hotchk155/MIDI-Switcher-2/docs/Relay Switcher/Relay Switcher - Packing Slip.docx

RELAY SWITCHER

The information on this page is the bare minimum needed to build the project,

however you will find more information at http://six4pix.com/relays

I recommend you check the expanded instructions before you start building the board.

Here are the component designators used on the PCB:

R1, R11 R2-R9 R10, R12 R13 C1 C2,C3,C4 C5 D2 D3 PWR, ACT IC1 IC2 IC3 MODE 5VDC MIDI_IN | 1K RESISTOR (X2) 100R RESISTOR (x8) 1K5 RESISTOR (X2) 220R RESISTOR R10 is the unlabelled resistor above R11. R3-R9 are the unlabelled resistors between R2 and R10. 47UF 50V ELECTROLYTIC CAPACITOR 100nF CERAMIC CAPACITOR (X3) 4U7 10V ELECTROLYTIC CAPACITOR 1N4001 RECTIFIER DIODE 1N4148 SIGNAL DIODE 3MM LEDS (x2) PIC16F1825 MICROCONTROLLER (In Socket) 6N138 OPTOCOUPLER (In Socket) 3.3V 0.1A VOLTAGE REGULATOR TO92 6MM TACTILE SWITCH DOUBLE TERMINAL BLOCK 5MM 5 PIN DIN PCB MOUNT SOCKET Please carefully check the polarity of C1, C5, D2, D3, IC3 and all LEDs before soldering!

Solder the module to the pin header on the relay board.

Attach the 4 nylon stand-offs to the base plate using the screws.

Place the relay board on the stand-offs and use the nuts to secure the relay module to the base.

Use the brass stand-offs to support the relay switcher module above the upper part of the base plate.

The default MIDI note to port mapping is

Port | Note | | Port | Note
PORT A | C1 (36) | | PORT E | E1 (40)
PORT B | C#1 (37) | | PORT F | F1 (41)
PORT C | D1 (38) | | PORT G | F#1 (42)
PORT D | D#1 (39) | | PORT H | G1 (43)

The default receive channel is MIDI Channel 1 for all ports and outputs will remain trigged for the duration of the MIDI notes.

The configuration can be changed using MIDI sysex files that you can create using the web based configuration form at http://www.six4pix.uk/switcher/patch.asp

* Power the board from a 5VDC supply being careful to get the polarity correct. Do not power the module from a higher voltage supply – this may damage the relay module.

* The power supply should be able to provide at least 500mA at 5VDC

* I do not not advise using the module to switch mains electricity unless you are a qualified electrician or otherwise competent to work on mains supplies. If you do so, it is AT YOUR OWN RISK.

* To electrically isolate the relay coil drivers from the Relay Switcher microprocessor module requires a second DC power supply and removal of the jumper on the relay module. You should consider this step if you are switching mains power with this module. Please check the web site for information.

* Always check the manual if you have any doubts

* Have Fun!

Feel free to contact me at sixtyfourpixels@gmail.com with questions, suggestions and feedback.

RELAY SWITCHER

The information on this page is the bare minimum needed to build the project,

however you will find more information at http://six4pix.com/relays

I recommend you check the expanded instructions before you start building the board.

Here are the component designators used on the PCB:

R1, R11 R2-R9 R10, R12 R13 C1 C2,C3,C4 C5 D2 D3 PWR, ACT IC1 IC2 IC3 MODE 5VDC MIDI_IN | 1K RESISTOR (X2) 100R RESISTOR (x8) 1K5 RESISTOR (X2) 220R RESISTOR R10 is the unlabelled resistor above R11. R3-R9 are the unlabelled resistors between R2 and R10. 47UF 50V ELECTROLYTIC CAPACITOR 100nF CERAMIC CAPACITOR (X3) 4U7 10V ELECTROLYTIC CAPACITOR 1N4001 RECTIFIER DIODE 1N4148 SIGNAL DIODE 3MM LEDS (x2) PIC16F1825 MICROCONTROLLER (In Socket) 6N138 OPTOCOUPLER (In Socket) 3.3V 0.1A VOLTAGE REGULATOR TO92 6MM TACTILE SWITCH DOUBLE TERMINAL BLOCK 5MM 5 PIN DIN PCB MOUNT SOCKET Please carefully check the polarity of C1, C5, D2, D3, IC3 and all LEDs before soldering!

Solder the module to the pin header on the relay board.

Attach the 4 nylon stand-offs to the base plate using the screws.

Place the relay board on the stand-offs and use the nuts to secure the relay module to the base.

Use the brass stand-offs to support the relay switcher module above the upper part of the base plate.

The default MIDI note to port mapping is

Port | Note | | Port | Note
PORT A | C1 (36) | | PORT E | E1 (40)
PORT B | C#1 (37) | | PORT F | F1 (41)
PORT C | D1 (38) | | PORT G | F#1 (42)
PORT D | D#1 (39) | | PORT H | G1 (43)

The default receive channel is MIDI Channel 1 for all ports and outputs will remain trigged for the duration of the MIDI notes.

The configuration can be changed using MIDI sysex files that you can create using the web based configuration form at http://www.six4pix.uk/switcher/patch.asp

* Power the board from a 5VDC supply being careful to get the polarity correct. Do not power the module from a higher voltage supply – this may damage the relay module.

* The power supply should be able to provide at least 500mA at 5VDC

* I do not not advise using the module to switch mains electricity unless you are a qualified electrician or otherwise competent to work on mains supplies. If you do so, it is AT YOUR OWN RISK.

* To electrically isolate the relay coil drivers from the Relay Switcher microprocessor module requires a second DC power supply and removal of the jumper on the relay module. You should consider this step if you are switching mains power with this module. Please check the web site for information.

* Always check the manual if you have any doubts

* Have Fun!

Feel free to contact me at sixtyfourpixels@gmail.com with questions, suggestions and feedback.
