hotchk155/MIDI-Switcher-2/docs/MIDI Switcher/combo.docx

Rename “Note On”

Add “Note Off” (can use velocity of zero??)

Mode

OnTrig

OnUntrig

Toggle

Custom

Combination

Custom Mode

Trigger

A CC1 toggle

B CC2 toggle

C CC3 momentary

Output A = A|B^C

Output B = !A|B^C

A

A [ANY OF] A B

B

C

D

Trigger Conditions -> Output
