hotchk155/MIDI-Switcher-2/docs/Relay Switcher/bom.txt

8 OFF M3x6 screw 
4 OFF M3 nut
4 OFF M3 5+5 F-M Spacer
2 OFF M3 11MM F-F Spacer
4 OFF Rubber Feet
