hotchk155/MIDI-Switcher-2/docs/MIDI Switcher/BOM.xlsx

MIDI SWITCHER REV3 BOM
SURFACE MOUNT COMPONENTS
C1 | 100n
C2 | 100n
C3 | 100n
D1 | 1N4148
IC2 | PIC16F1825
IC3 | LD1086 +5V REGULATOR
L1 | 0805 LED BLUE | Labelled ACT
L2 | 0805 LED RED | Labelled PWR
L3 | 0805 LED BLUE
L4 | 0805 LED BLUE
L5 | 0805 LED BLUE
L6 | 0805 LED BLUE
L7 | 0805 LED BLUE
L8 | 0805 LED BLUE
L9 | 0805 LED BLUE
L10 | 0805 LED BLUE
Q1 | MJD122 DARLINGTON TRANSISTOR
Q2 | MJD122 DARLINGTON TRANSISTOR
Q3 | MJD122 DARLINGTON TRANSISTOR
Q4 | MJD122 DARLINGTON TRANSISTOR
Q5 | MJD122 DARLINGTON TRANSISTOR
Q6 | MJD122 DARLINGTON TRANSISTOR
Q7 | MJD122 DARLINGTON TRANSISTOR
Q8 | MJD122 DARLINGTON TRANSISTOR
Q9 | MMBT3906 PNP TRANSISTOR
R1 | 220R
R2 | 1K
R3 | 1K
R7 | 1K | R7-R20 are resistors in a row from below R3 to beside C3
R8 | 1K | "
R9 | 1K | "
R10 | 1K | "
R11 | 1K | "
R12 | 1K | "
R13 | 1K | "
R14 | 1K | "
R15 | 1K | "
R16 | 1K | "
R17 | 1K | "
R18 | 1K | "
R19 | 1K | "
R20 | 1K | "
R21 | 1K5
R22 | 1K5
R23 | 1K
R24 | 1K
R25 | 1K
THROUGH-HOLE COMPONENTS
C4 | 47u | Needs to be >= 35V cap
C5 | 47u | Can be lower value
D2 | 1N4004
D3 | 1N4004
IC1 | 6N138
MIDI_IN | 5 PIN DIN SOCKET
MODE | TACT SWITCH
POWER | 2.1MM DC POWER JACK
