hotchk155/MIDI-Switcher-2/midi_switcher_smt/midi-switcher-bom.xlsx

Comment | Designator | Footprint | JLCPCB Part #（optional）
100n | C1 | 0805
100n | C2 | 0805
100n | C3 | 0805
TS4148 | D1 | 0805
PIC16F1825-I/SL | IC2 | SOIC-14 | C19649
LD1086DT50TR | IC3 | DPAK | C164853
blue | L1 | 0805
red | L2 | 0805
blue | L3 | 0805
blue | L4 | 0805
blue | L5 | 0805
blue | L6 | 0805
blue | L7 | 0805
blue | L8 | 0805
blue | L9 | 0805
blue | L10 | 0805
MJD122G | Q1 | DPAK | C89910
MJD122G | Q2 | DPAK | C89910
MJD122G | Q3 | DPAK | C89910
MJD122G | Q4 | DPAK | C89910
MJD122G | Q5 | DPAK | C89910
MJD122G | Q6 | DPAK | C89910
MJD122G | Q7 | DPAK | C89910
MJD122G | Q8 | DPAK | C89910
MMBT3906 | Q9 | SOT23-3
220 | R1 | R0805
1k | R2 | R0805
1k | R3 | R0805
1k | R7 | R0805
1k | R8 | R0805
1k | R9 | R0805
1k | R10 | R0805
1k | R11 | R0805
1k | R12 | R0805
1k | R13 | R0805
1k | R14 | R0805
1k | R15 | R0805
1k | R16 | R0805
1k | R17 | R0805
1k | R18 | R0805
1k | R19 | R0805
1k | R20 | R0805
1.5k | R21 | R0805
1.5k | R22 | R0805
1k | R23 | R0805
1k | R24 | R0805
1k | R25 | R0805
