hotchk155/MIDI-Switcher-2/docs/MIDI Switcher/build_test.docx

Test resistors using multimeter. Check for shorts. Validate values. Check for shorts across caps C2, C3. 6KOhm range on Fluke meter

Diode check – on opto pin 2 (-), 3 (+)

Bootloader install

Load test firmware. Check all LEDs. Check switch outputs

Load release firmware

Load default patch

Check MIDI thru
