hotchk155/MIDI-Switcher-2/midi_switcher_smt/midi-switcher-smt.brd

## EAGLE design midi_switcher_smt/midi-switcher-smt.brd (2026-02-06)

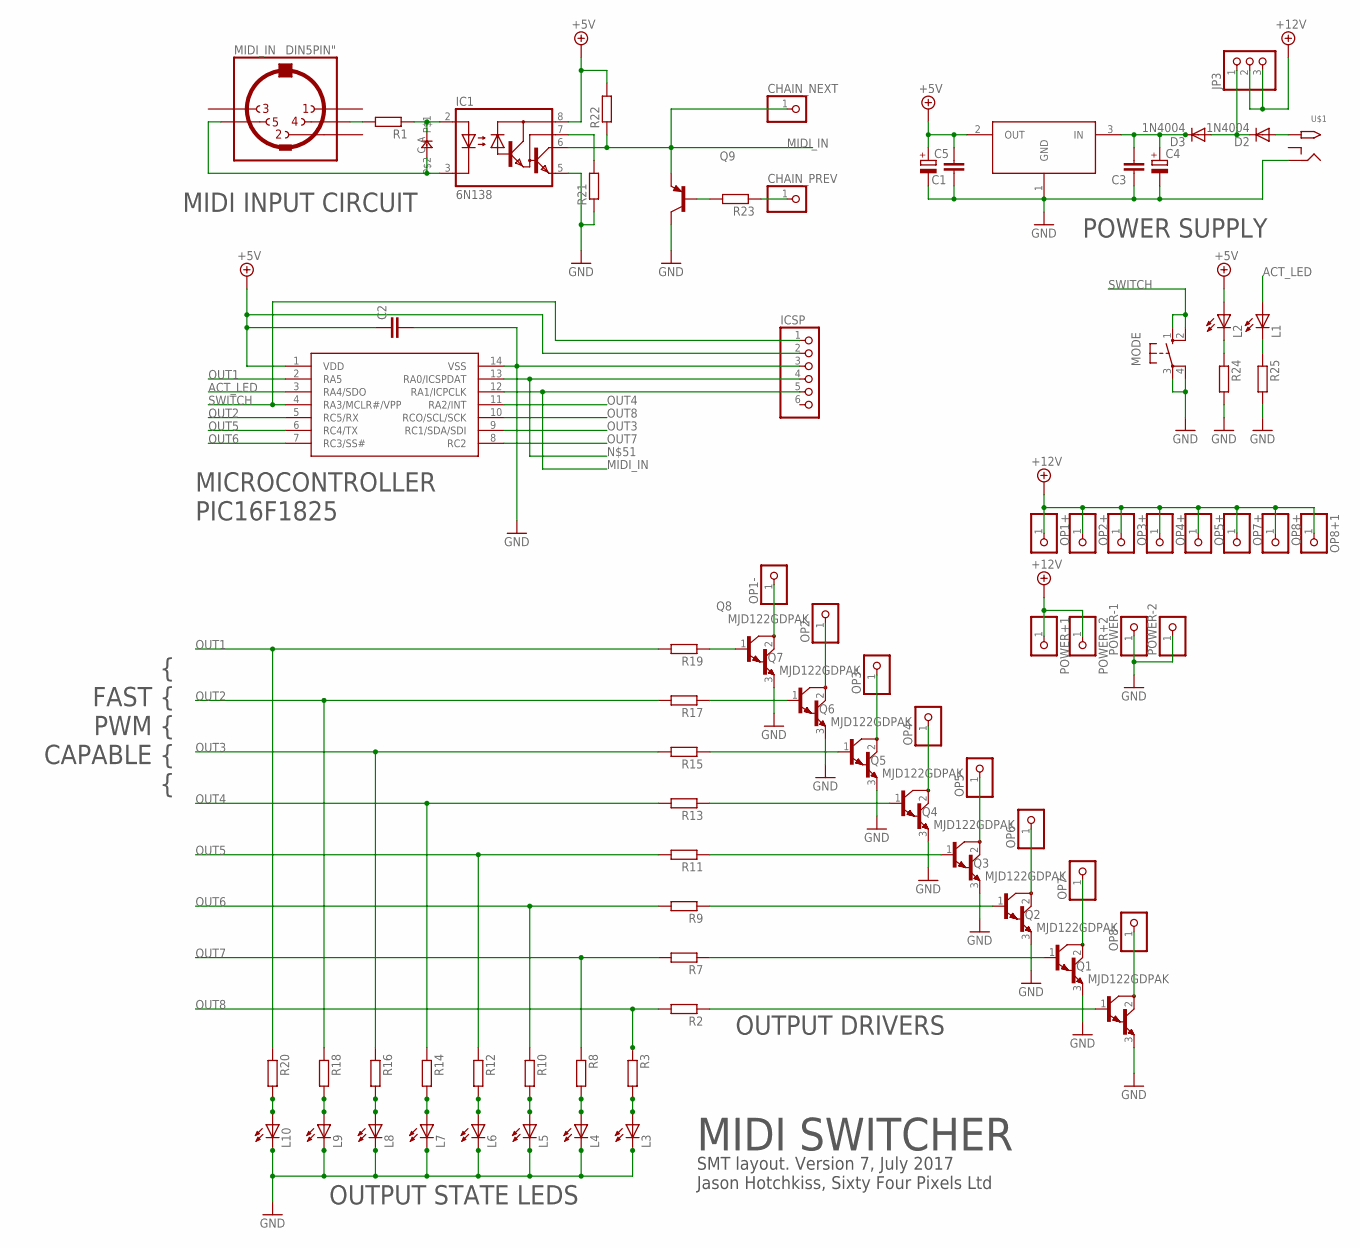
[picture p12: schematic midi-switcher-smt.sch]

Parts:
C1, C2, C3: C-EUC0805; C0805
C4: CPOL-EUE2.5-7; E2,5-7
C5: CPOL-EUE2.5-6; E2,5-6
CHAIN_NEXT: PINHD-1X1; 1X01
CHAIN_PREV: PINHD-1X1; 1X01
D1: 0805DIODE
D2, D3: 1N4004; DO-VERT
IC1: 6N138; DIL08
IC2: PIC16F1825SO14; SO14
IC3: LD1086; DPACK
ICSP: HEADER-1X6; 1X06_OVAL
JP3: PINHD-1X3; 1X03
L1, L2, L3, L4, L5, L6, L7, L8, L9, L10: LEDCHIP-LED0805; CHIP-LED0805
MIDI_IN: DIN5PIN"; TRUCONN90
MODE: 10-XX; B3F-10XX
OP1+, OP1-, OP2+, OP2-, OP3+, OP3-, OP4+, OP4-, OP5+, OP5-, OP6-, OP7+, OP7-, OP8+, OP8+1, OP8-: PINHD-1X1; 1X01W
POWER+1, POWER+2: PINHD-1X1; 1X01W
POWER-1, POWER-2: PINHD-1X1; 1X01W
Q1, Q2, Q3, Q4, Q5, Q6, Q7, Q8: MJD122GDPAK; DPACK
Q9: MMBT3906LT1-PNP-SOT23-BEC; SOT23-BEC
R1, R2, R3, R7, R8, R9, R10, R11, R12, R13, R14, R15, R16, R17, R18, R19, R20, R21, R22, R23, R24, R25: R-EU_R0805; R0805
U$1: 2.1MMJACKTHM; PJ-102A

Connections:
+5V: C1.2, C2.1, C5.+, IC1.8 (VCC), IC2.1 (VDD), IC3.2 (OUT), ICSP.2, L2.A, R22.2
+12V: JP3.2, JP3.3, OP1+.1, OP2+.1, OP3+.1, OP4+.1, OP5+.1, OP7+.1, OP8+.1, OP8+1.1, POWER+1.1, POWER+2.1
ACT_LED: IC2.3 (RA4/SDO), L1.A
GND: C1.1, C2.2, C3.1, C4.-, C5.-, IC1.5 (GND), IC2.14 (VSS), IC3.1 (GND), ICSP.3, L3.C, L4.C, L5.C, L6.C, L7.C, L8.C, L9.C, L10.C, MODE.3, MODE.4 (P1), POWER-1.1, POWER-2.1, Q1.3 (E), Q2.3 (E), Q3.3 (E), Q4.3 (E), Q5.3 (E), Q6.3 (E), Q7.3 (E), Q8.3 (E), Q9.C, R21.1, R24.2, R25.2, U$1.RING
MIDI_IN: CHAIN_NEXT.1, IC1.6 (VO), IC2.12 (RA1/ICPCLK), ICSP.5, Q9.E, R22.1
unnamed: D1.C, IC1.3 (C), MIDI_IN.5
unnamed: MIDI_IN.4, R1.2
unnamed: D1.A, IC1.2 (A), R1.1
unnamed: IC1.7 (VB), R21.2
unnamed: L1.C, R25.1
unnamed: L10.A, R20.2
unnamed: L9.A, R18.2
unnamed: Q8.1 (B), R19.1
unnamed: Q7.1 (B), R17.1
unnamed: Q6.1 (B), R15.1
unnamed: Q5.1 (B), R13.1
unnamed: Q4.1 (B), R11.1
unnamed: Q3.1 (B), R9.1
unnamed: Q2.1 (B), R7.1
unnamed: Q1.1 (B), R2.1
unnamed: Q9.B, R23.2
unnamed: CHAIN_PREV.1, R23.1
unnamed: L8.A, R16.2
unnamed: OP1-.1, Q8.2 (C)
unnamed: OP2-.1, Q7.2 (C)
unnamed: OP3-.1, Q6.2 (C)
unnamed: L2.C, R24.1
unnamed: OP5-.1, Q4.2 (C)
unnamed: OP6-.1, Q3.2 (C)
unnamed: OP4-.1, Q5.2 (C)
unnamed: L7.A, R14.2
unnamed: L6.A, R12.2
unnamed: L5.A, R10.2
unnamed: L4.A, R8.2
unnamed: L3.A, R3.2
unnamed: C3.2, C4.+, D3.C, IC3.3 (IN)
unnamed: OP7-.1, Q2.2 (C)
unnamed: D2.A, U$1.TIP
unnamed: OP8-.1, Q1.2 (C)
unnamed: IC2.13 (RA0/ICSPDAT), ICSP.4
unnamed: D2.C, D3.A, JP3.1
OUT1: IC2.2 (RA5), R19.2, R20.1
OUT2: IC2.5 (RC5/RX), R17.2, R18.1
OUT3: IC2.9 (RC1/SDA/SDI), R15.2, R16.1
OUT4: IC2.11 (RA2/INT), R13.2, R14.1
OUT5: IC2.6 (RC4/TX), R11.2, R12.1
OUT6: IC2.7 (RC3/SS#), R9.2, R10.1
OUT7: IC2.8 (RC2), R7.2, R8.1
OUT8: IC2.10 (RCO/SCL/SCK), R2.2, R3.1
SWITCH: IC2.4 (RA3/MCLR#/VPP), ICSP.1, MODE.1 (S), MODE.2 (S1)

Notes on the sheet:
MIDI SWITCHER
SMT layout. Version 7, July 2017 Jason Hotchkiss, Sixty Four Pixels Ltd
MIDI INPUT CIRCUIT
MICROCONTROLLER PIC16F1825
POWER SUPPLY
OUTPUT STATE LEDS
OUTPUT DRIVERS
{ FAST { PWM { CAPABLE { {

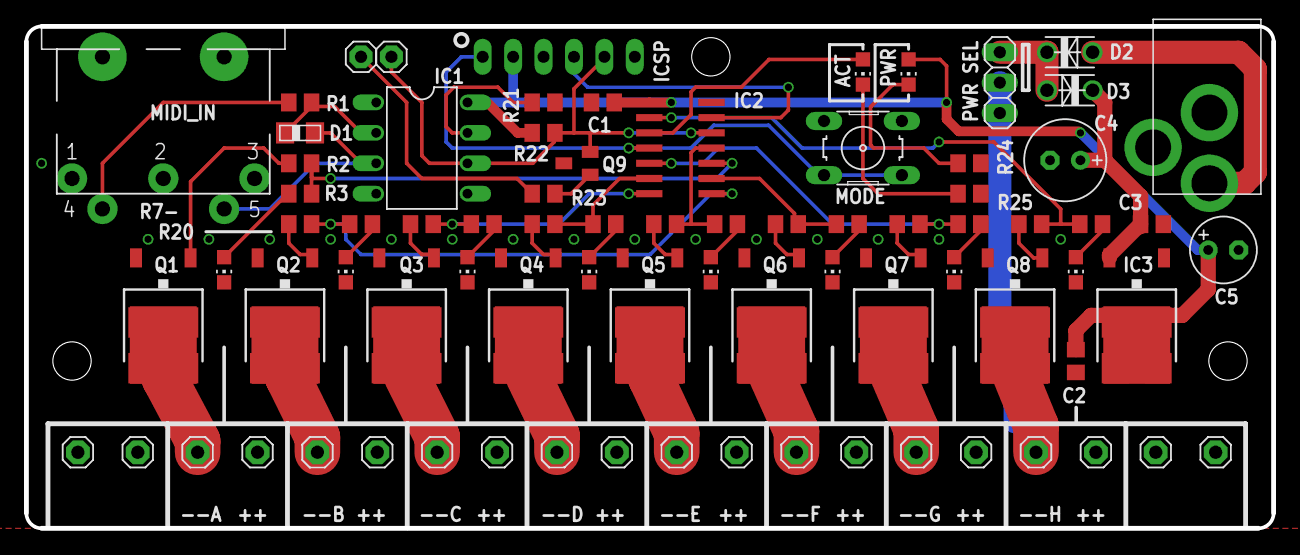
[picture p13: board midi-switcher-smt.brd from above]

Board: 2 copper layers, 104.1 x 41.9 mm, 79 parts (0 on the bottom side), 50 nets.
