hotchk155/MIDI-Switcher-2/relay_sw_ssr/ssr_board.brd

## EAGLE design relay_sw_ssr/ssr_board.brd (2021-12-11)

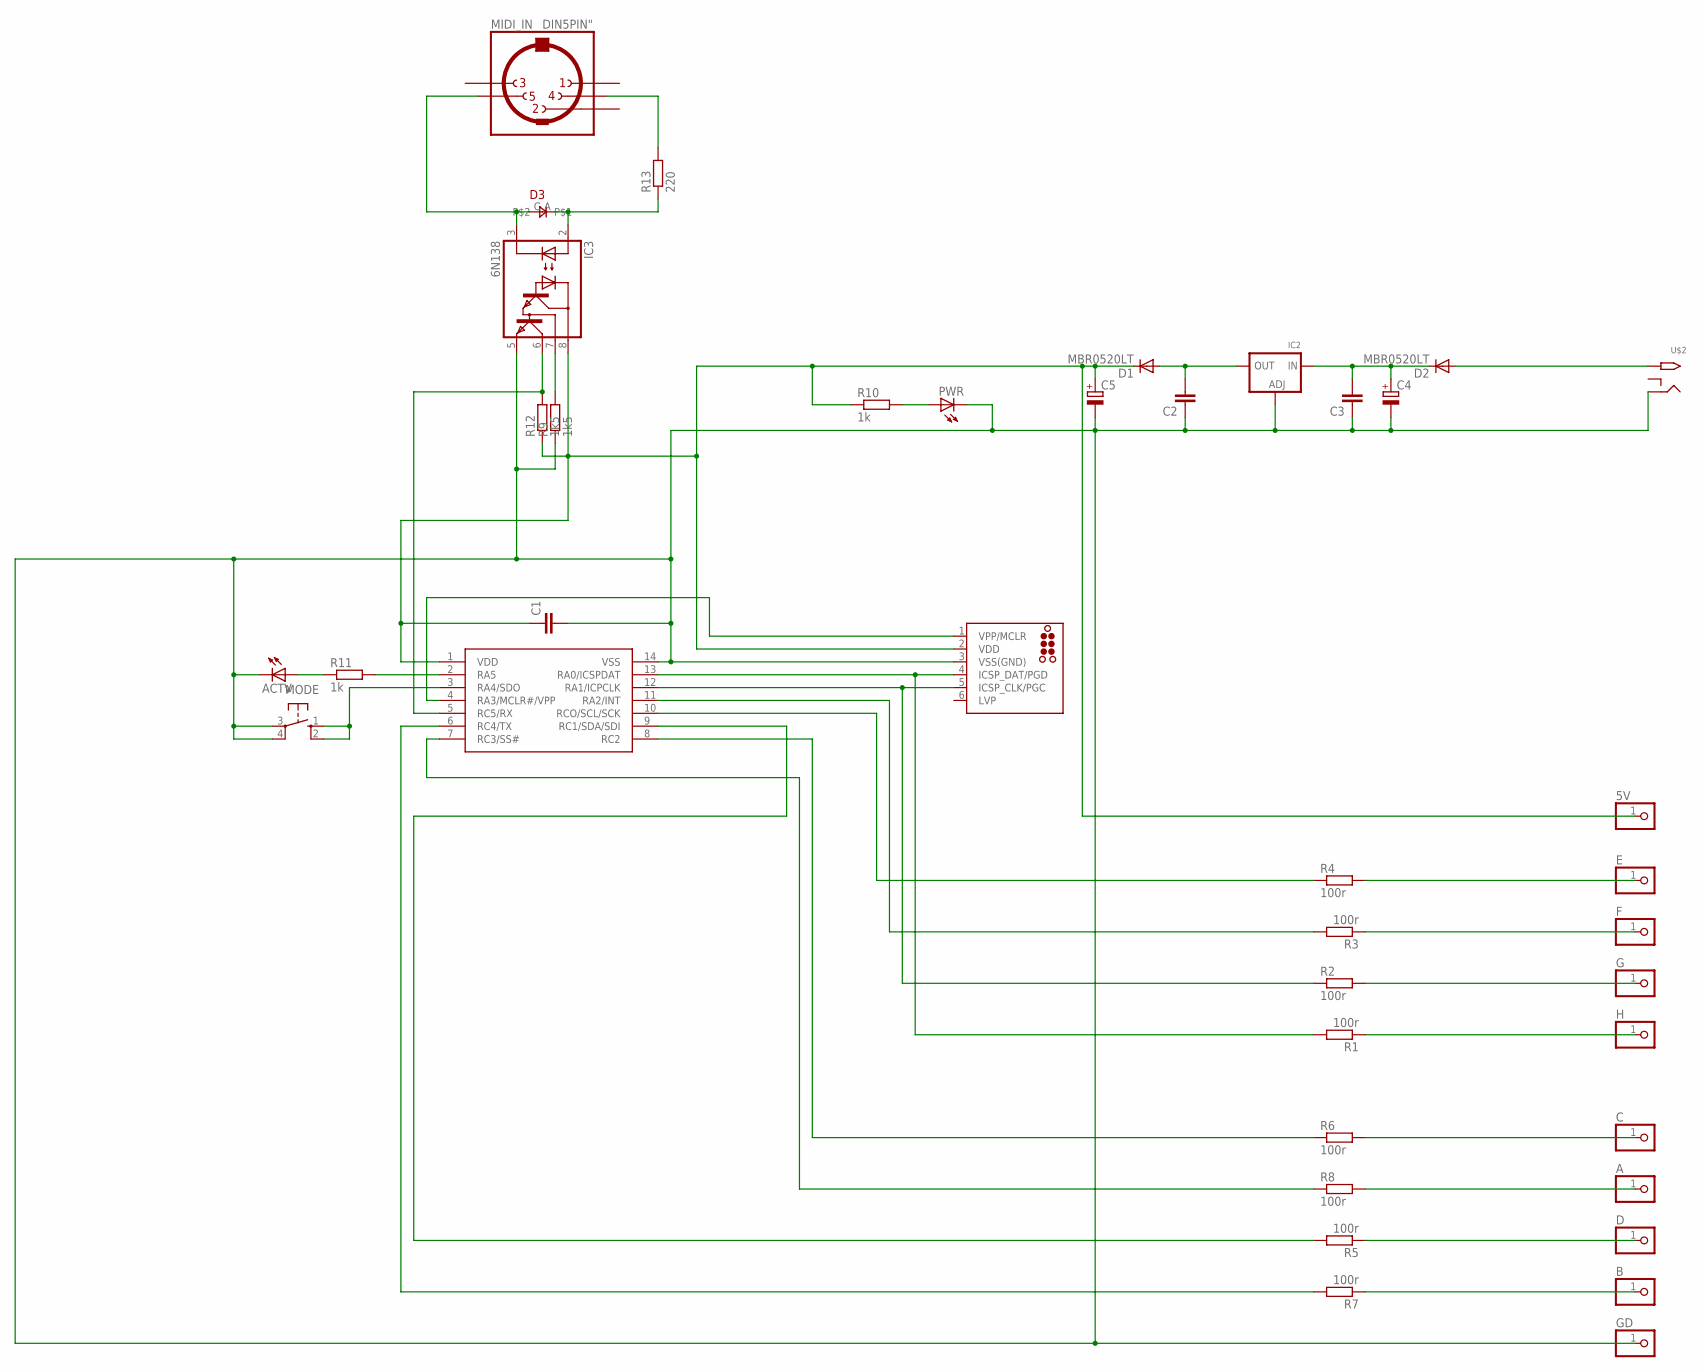
[picture p14: schematic ssr_board.sch]

Parts:
5V: PINHD-1X1; 1X01
A: PINHD-1X1; 1X01
ACTV: LED3MM
B: PINHD-1X1; 1X01
C: PINHD-1X1; 1X01
C1, C2, C3: C-EUC0805; C0805
C4, C5: CPOL-EUE2-5; E2-5
D: PINHD-1X1; 1X01
D1, D2: MBR0520LT; SOD123
D3: 0805DIODE
E: PINHD-1X1; 1X01
F: PINHD-1X1; 1X01
G: PINHD-1X1; 1X01
GD: PINHD-1X1; 1X01
H: PINHD-1X1; 1X01
IC1: PIC16F1825SO14; SO14
IC2: LM1117SOT223-WAVE; SOT223-W
IC3: 6N138; DIL08
ICSP: TC2030-MCP-NL
MIDI_IN: DIN5PIN"; TRUCONN90
MODE: 10-XX; B3F-10XX
PWR: LED3MM
R1, R2, R3, R4, R5, R6, R7, R8: 100r; R0805
R9, R12: 1k5; R0805
R10, R11: 1k; R0805
R13: 220; R0805
U$2: 2.1MMJACKTHM; PJ-102A

Connections:
5V: 5V.1, C1.1, C5.+, D1.C, IC1.1 (VDD), IC3.8 (VCC), ICSP.2 (VDD), R10.1, R12.1
GND: ACTV.K (C), C1.2, C2.1, C3.1, C4.-, C5.-, GD.1, IC1.14 (VSS), IC2.1 (ADJ), IC3.5 (GND), ICSP.3 (VSS(GND)), MODE.3, MODE.4 (P1), PWR.K (C), R9.1, U$2.RING
unnamed: C2.2, D1.A, IC2.2 (OUT)
unnamed: D2.A, U$2.TIP
unnamed: PWR.A, R10.2
unnamed: C3.2, C4.+, D2.C, IC2.3 (IN)
unnamed: MIDI_IN.4, R13.2
unnamed: D3.A, IC3.2 (A), R13.1
unnamed: D3.C, IC3.3 (C), MIDI_IN.5
unnamed: IC3.7 (VB), R9.2
unnamed: F.1, R3.1
unnamed: G.1, R2.2
unnamed: H.1, R1.1
unnamed: C.1, R6.2
unnamed: A.1, R8.2
unnamed: D.1, R5.1
unnamed: B.1, R7.1
unnamed: IC1.12 (RA1/ICPCLK), ICSP.5 (ICSP_CLK/PGC), R2.1
unnamed: IC1.13 (RA0/ICSPDAT), ICSP.4 (ICSP_DAT/PGD), R1.2
unnamed: IC1.8 (RC2), R6.1
unnamed: IC1.7 (RC3/SS#), R8.1
unnamed: IC1.9 (RC1/SDA/SDI), R5.2
unnamed: IC1.6 (RC4/TX), R7.2
unnamed: E.1, R4.2
unnamed: IC1.4 (RA3/MCLR#/VPP), ICSP.1 (VPP/MCLR)
unnamed: IC1.3 (RA4/SDO), MODE.1 (S), MODE.2 (S1)
unnamed: IC1.11 (RA2/INT), R3.2
unnamed: IC1.10 (RCO/SCL/SCK), R4.1
unnamed: IC1.5 (RC5/RX), IC3.6 (VO), R12.2
unnamed: ACTV.A, R11.1
unnamed: IC1.2 (RA5), R11.2

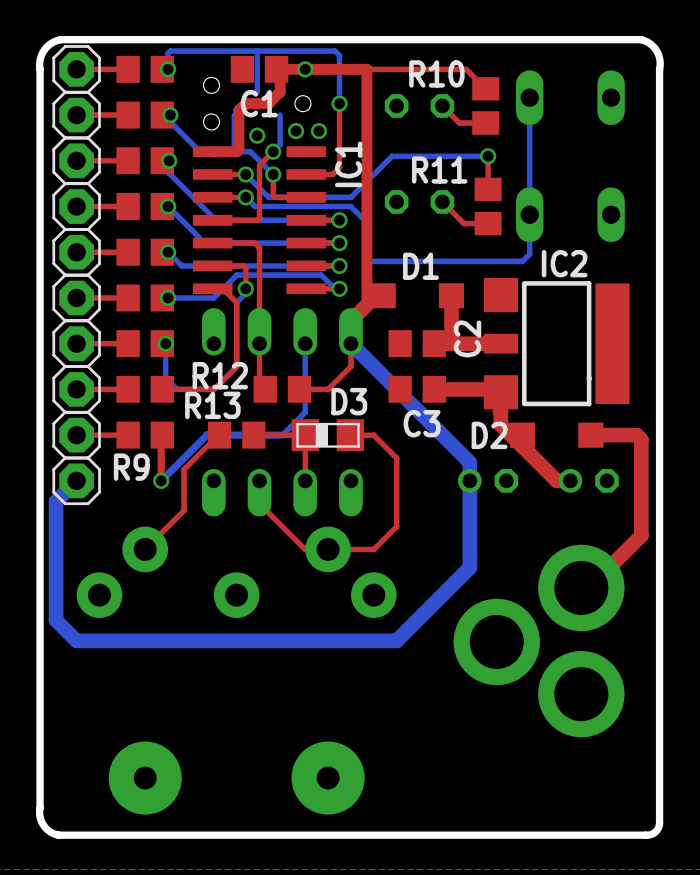
[picture p15: board ssr_board.brd from above]

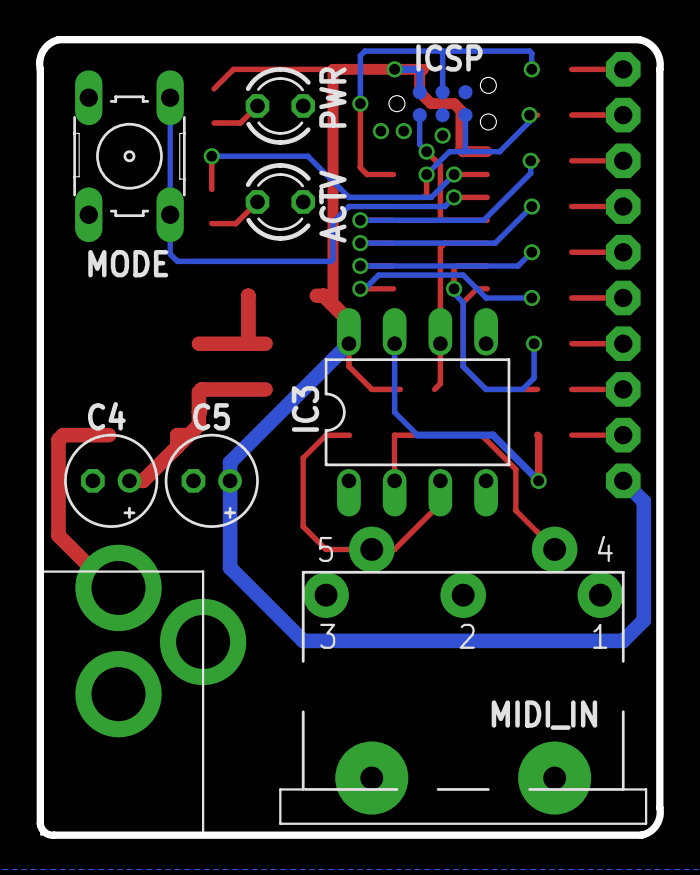
[picture p16: board ssr_board.brd from below]

Board: 2 copper layers, 34.5 x 44.2 mm, 40 parts (9 on the bottom side), 31 nets.
