hotchk155/MIDI-Switcher-2/midi_switcher_dpdt/midi-switcher-dpdt.brd

## EAGLE design midi_switcher_dpdt/midi-switcher-dpdt.brd (2021-07-29)

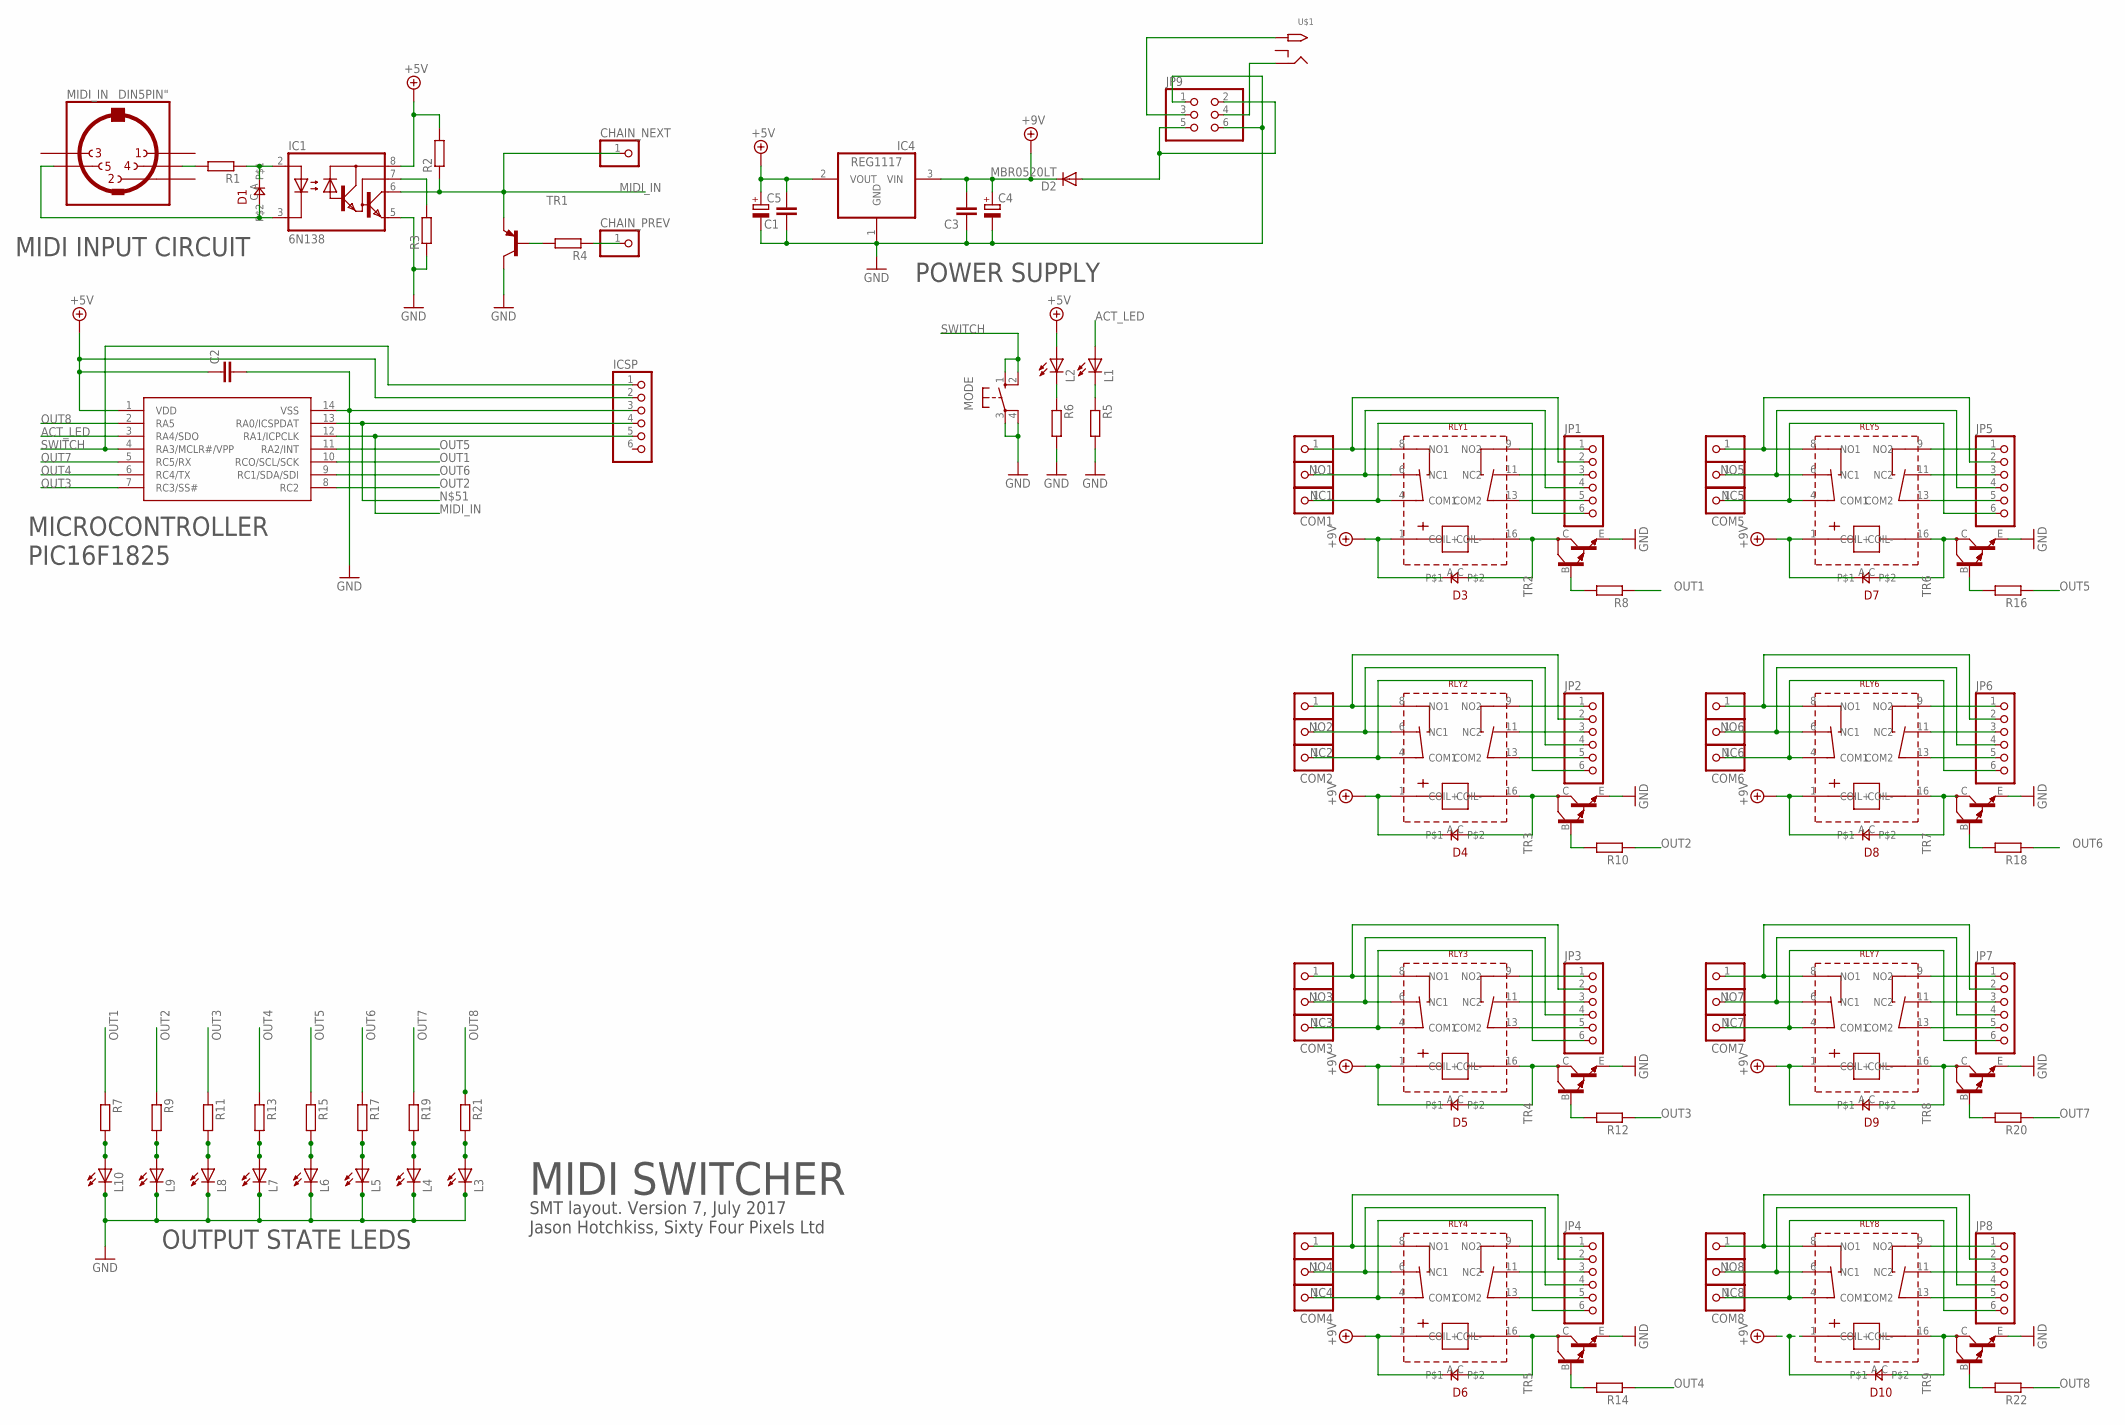
[picture p17: schematic midi-switcher-dpdt.sch]

Parts:
C1, C2, C3: C-EUC0805; C0805
C4, C5: CPOL-EUE2,5-6E; E2,5-6E
CHAIN_NEXT: PINHD-1X1; 1X01
CHAIN_PREV: PINHD-1X1; 1X01
COM1, COM2, COM3, COM4, COM5, COM6, COM7, COM8: PINHD-1X1; 1X01
D1, D3, D4, D5, D6, D7, D8, D9, D10: 0805DIODE
D2: MBR0520LT; SOD123
IC1: 6N138; DIL08
IC2: PIC16F1825SO14; SO14
IC4: REG1117; SOT223
ICSP: HEADER-1X6; 1X06_OVAL
JP1, JP2, JP3, JP4, JP5, JP6, JP7, JP8: PINHD-1X6; 1X06
JP9: PINHD-2X3; 2X03
L1, L2, L3, L4, L5, L6, L7, L8, L9, L10: LEDCHIP-LED0805; CHIP-LED0805
MIDI_IN: DIN5PIN"; TRUCONN90
MODE: 10-XX; B3F-10XX
NC1, NC2, NC3, NC4, NC5, NC6, NC7, NC8: PINHD-1X1; 1X01
NO1, NO2, NO3, NO4, NO5, NO6, NO7, NO8: PINHD-1X1; 1X01
R1, R2, R3, R4, R5, R6, R7, R8, R9, R10, R11, R12, R13, R14, R15, R16, R17, R18, R19, R20, R21, R22: R-EU_R0805; R0805
RLY1, RLY2, RLY3, RLY4, RLY5, RLY6, RLY7, RLY8: HFD2RELAY
TR1: MMBT3906LT1-PNP-SOT23-BEC; SOT23-BEC
TR2, TR3, TR4, TR5, TR6, TR7, TR8, TR9: MMBTA13LT1-NPN_DARL-SOT23-BEC; SOT23-BEC
U$1: 2.1MMJACKTHM; PJ-102A

Connections:
+5V: C1.2, C2.1, C5.+, IC1.8 (VCC), IC2.1 (VDD), IC4.2 (VOUT), ICSP.2, L2.A, R2.2
+9V: C3.2, C4.+, D2.C, D3.A, D4.A, D5.A, D6.A, D7.A, D8.A, D9.A, D10.A, IC4.3 (VIN), RLY1.1 (COIL+), RLY2.1 (COIL+), RLY3.1 (COIL+), RLY4.1 (COIL+), RLY5.1 (COIL+), RLY6.1 (COIL+), RLY7.1 (COIL+), RLY8.1 (COIL+)
ACT_LED: IC2.3 (RA4/SDO), L1.A
GND: C1.1, C2.2, C3.1, C4.-, C5.-, IC1.5 (GND), IC2.14 (VSS), IC4.1 (GND), ICSP.3, JP9.1, JP9.6, L3.C, L4.C, L5.C, L6.C, L7.C, L8.C, L9.C, L10.C, MODE.3, MODE.4 (P1), R3.1, R5.2, R6.2, TR1.C, TR2.E, TR3.E, TR4.E, TR5.E, TR6.E, TR7.E, TR8.E, TR9.E
MIDI_IN: CHAIN_NEXT.1, IC1.6 (VO), IC2.12 (RA1/ICPCLK), ICSP.5, R2.1, TR1.E
unnamed: D1.C, IC1.3 (C), MIDI_IN.5
unnamed: MIDI_IN.4, R1.2
unnamed: D1.A, IC1.2 (A), R1.1
unnamed: IC1.7 (VB), R3.2
unnamed: L1.C, R5.1
unnamed: L10.A, R7.2
unnamed: L9.A, R9.2
unnamed: D3.C, RLY1.16 (COIL-), TR2.C
unnamed: R8.2, TR2.B
unnamed: JP9.3, U$1.TIP
unnamed: D4.C, RLY2.16 (COIL-), TR3.C
unnamed: R10.2, TR3.B
unnamed: JP9.4, U$1.RING
unnamed: D5.C, RLY3.16 (COIL-), TR4.C
unnamed: R12.2, TR4.B
unnamed: R4.2, TR1.B
unnamed: CHAIN_PREV.1, R4.1
unnamed: D6.C, RLY4.16 (COIL-), TR5.C
unnamed: R14.2, TR5.B
unnamed: D2.A, JP9.2, JP9.5
unnamed: JP1.2, NO1.1, RLY1.8 (NO1)
unnamed: L8.A, R11.2
unnamed: JP1.4, NC1.1, RLY1.6 (NC1)
unnamed: JP5.5, RLY5.13 (COM2)
unnamed: JP2.2, NO2.1, RLY2.8 (NO1)
unnamed: L2.C, R6.1
unnamed: JP2.4, NC2.1, RLY2.6 (NC1)
unnamed: COM2.1, JP2.6, RLY2.4 (COM1)
unnamed: JP3.2, NO3.1, RLY3.8 (NO1)
unnamed: JP3.4, NC3.1, RLY3.6 (NC1)
unnamed: L7.A, R13.2
unnamed: COM3.1, JP3.6, RLY3.4 (COM1)
unnamed: L6.A, R15.2
unnamed: L5.A, R17.2
unnamed: L4.A, R19.2
unnamed: L3.A, R21.2
unnamed: JP4.2, NO4.1, RLY4.8 (NO1)
unnamed: JP4.4, NC4.1, RLY4.6 (NC1)
unnamed: COM4.1, JP4.6, RLY4.4 (COM1)
unnamed: JP5.2, NO5.1, RLY5.8 (NO1)
unnamed: JP5.4, NC5.1, RLY5.6 (NC1)
unnamed: COM5.1, JP5.6, RLY5.4 (COM1)
unnamed: JP6.2, NO6.1, RLY6.8 (NO1)
unnamed: JP6.4, NC6.1, RLY6.6 (NC1)
unnamed: COM6.1, JP6.6, RLY6.4 (COM1)
unnamed: JP7.2, NO7.1, RLY7.8 (NO1)
unnamed: JP7.4, NC7.1, RLY7.6 (NC1)
unnamed: COM7.1, JP7.6, RLY7.4 (COM1)
unnamed: IC2.13 (RA0/ICSPDAT), ICSP.4
unnamed: JP8.2, NO8.1, RLY8.8 (NO1)
unnamed: JP8.4, NC8.1, RLY8.6 (NC1)
unnamed: COM8.1, JP8.6, RLY8.4 (COM1)
unnamed: D7.C, RLY5.16 (COIL-), TR6.C
unnamed: R16.2, TR6.B
unnamed: D8.C, RLY6.16 (COIL-), TR7.C
unnamed: R18.2, TR7.B
unnamed: D9.C, RLY7.16 (COIL-), TR8.C
unnamed: R20.2, TR8.B
unnamed: D10.C, RLY8.16 (COIL-), TR9.C
unnamed: R22.2, TR9.B
unnamed: JP5.3, RLY5.11 (NC2)
unnamed: JP1.5, RLY1.13 (COM2)
unnamed: JP1.3, RLY1.11 (NC2)
unnamed: JP1.1, RLY1.9 (NO2)
unnamed: JP5.1, RLY5.9 (NO2)
unnamed: COM1.1, JP1.6, RLY1.4 (COM1)
unnamed: JP2.1, RLY2.9 (NO2)
unnamed: JP2.3, RLY2.11 (NC2)
unnamed: JP2.5, RLY2.13 (COM2)
unnamed: JP3.5, RLY3.13 (COM2)
unnamed: JP3.1, RLY3.9 (NO2)
unnamed: JP3.3, RLY3.11 (NC2)
unnamed: JP4.5, RLY4.13 (COM2)
unnamed: JP4.3, RLY4.11 (NC2)
unnamed: JP4.1, RLY4.9 (NO2)
unnamed: JP6.5, RLY6.13 (COM2)
unnamed: JP6.3, RLY6.11 (NC2)
unnamed: JP6.1, RLY6.9 (NO2)
unnamed: JP7.5, RLY7.13 (COM2)
unnamed: JP7.3, RLY7.11 (NC2)
unnamed: JP7.1, RLY7.9 (NO2)
unnamed: JP8.5, RLY8.13 (COM2)
unnamed: JP8.3, RLY8.11 (NC2)
unnamed: JP8.1, RLY8.9 (NO2)
OUT1: IC2.10 (RCO/SCL/SCK), R7.1, R8.1
OUT2: IC2.8 (RC2), R9.1, R10.1
OUT3: IC2.7 (RC3/SS#), R11.1, R12.1
OUT4: IC2.6 (RC4/TX), R13.1, R14.1
OUT5: IC2.11 (RA2/INT), R15.1, R16.1
OUT6: IC2.9 (RC1/SDA/SDI), R17.1, R18.1
OUT7: IC2.5 (RC5/RX), R19.1, R20.1
OUT8: IC2.2 (RA5), R21.1, R22.1
SWITCH: IC2.4 (RA3/MCLR#/VPP), ICSP.1, MODE.1 (S), MODE.2 (S1)

Notes on the sheet:
MIDI SWITCHER
SMT layout. Version 7, July 2017 Jason Hotchkiss, Sixty Four Pixels Ltd
MIDI INPUT CIRCUIT
MICROCONTROLLER PIC16F1825
POWER SUPPLY
OUTPUT STATE LEDS

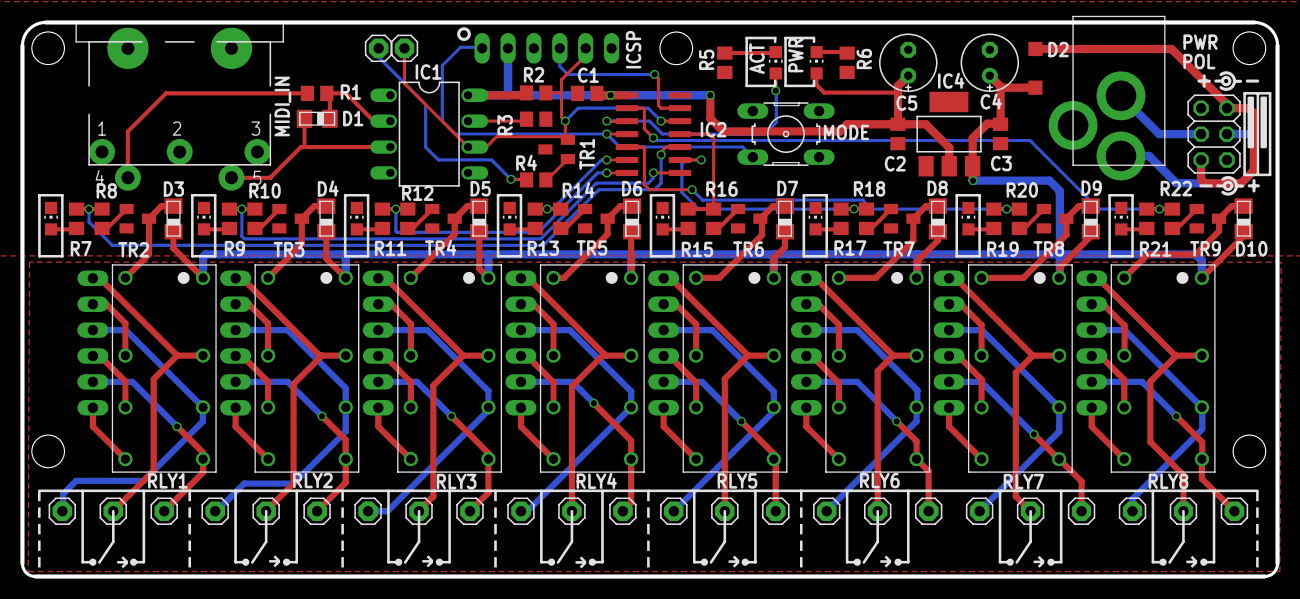
[picture p18: board midi-switcher-dpdt.brd from above]

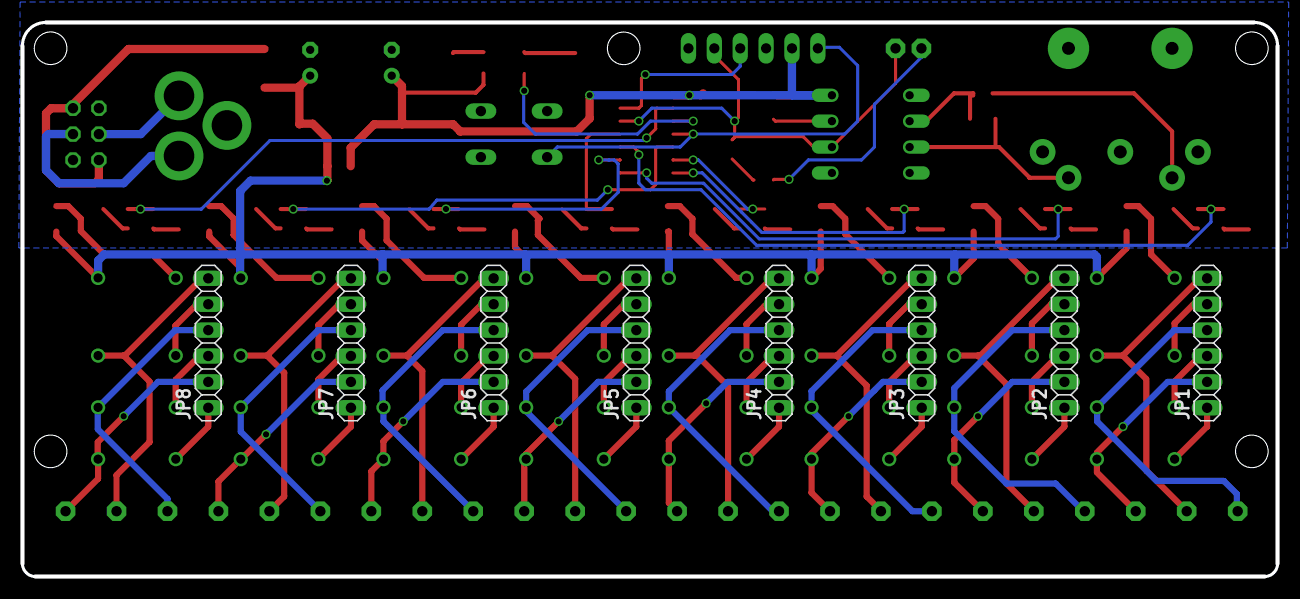
[picture p19: board midi-switcher-dpdt.brd from below]

Board: 2 copper layers, 123.1 x 54.4 mm, 106 parts (8 on the bottom side), 98 nets.
