hotchk155/MIDI-Switcher-2/midi_switcher_trs/midi_switcher_trs.brd

## EAGLE design midi_switcher_trs/midi_switcher_trs.brd (2021-07-27)

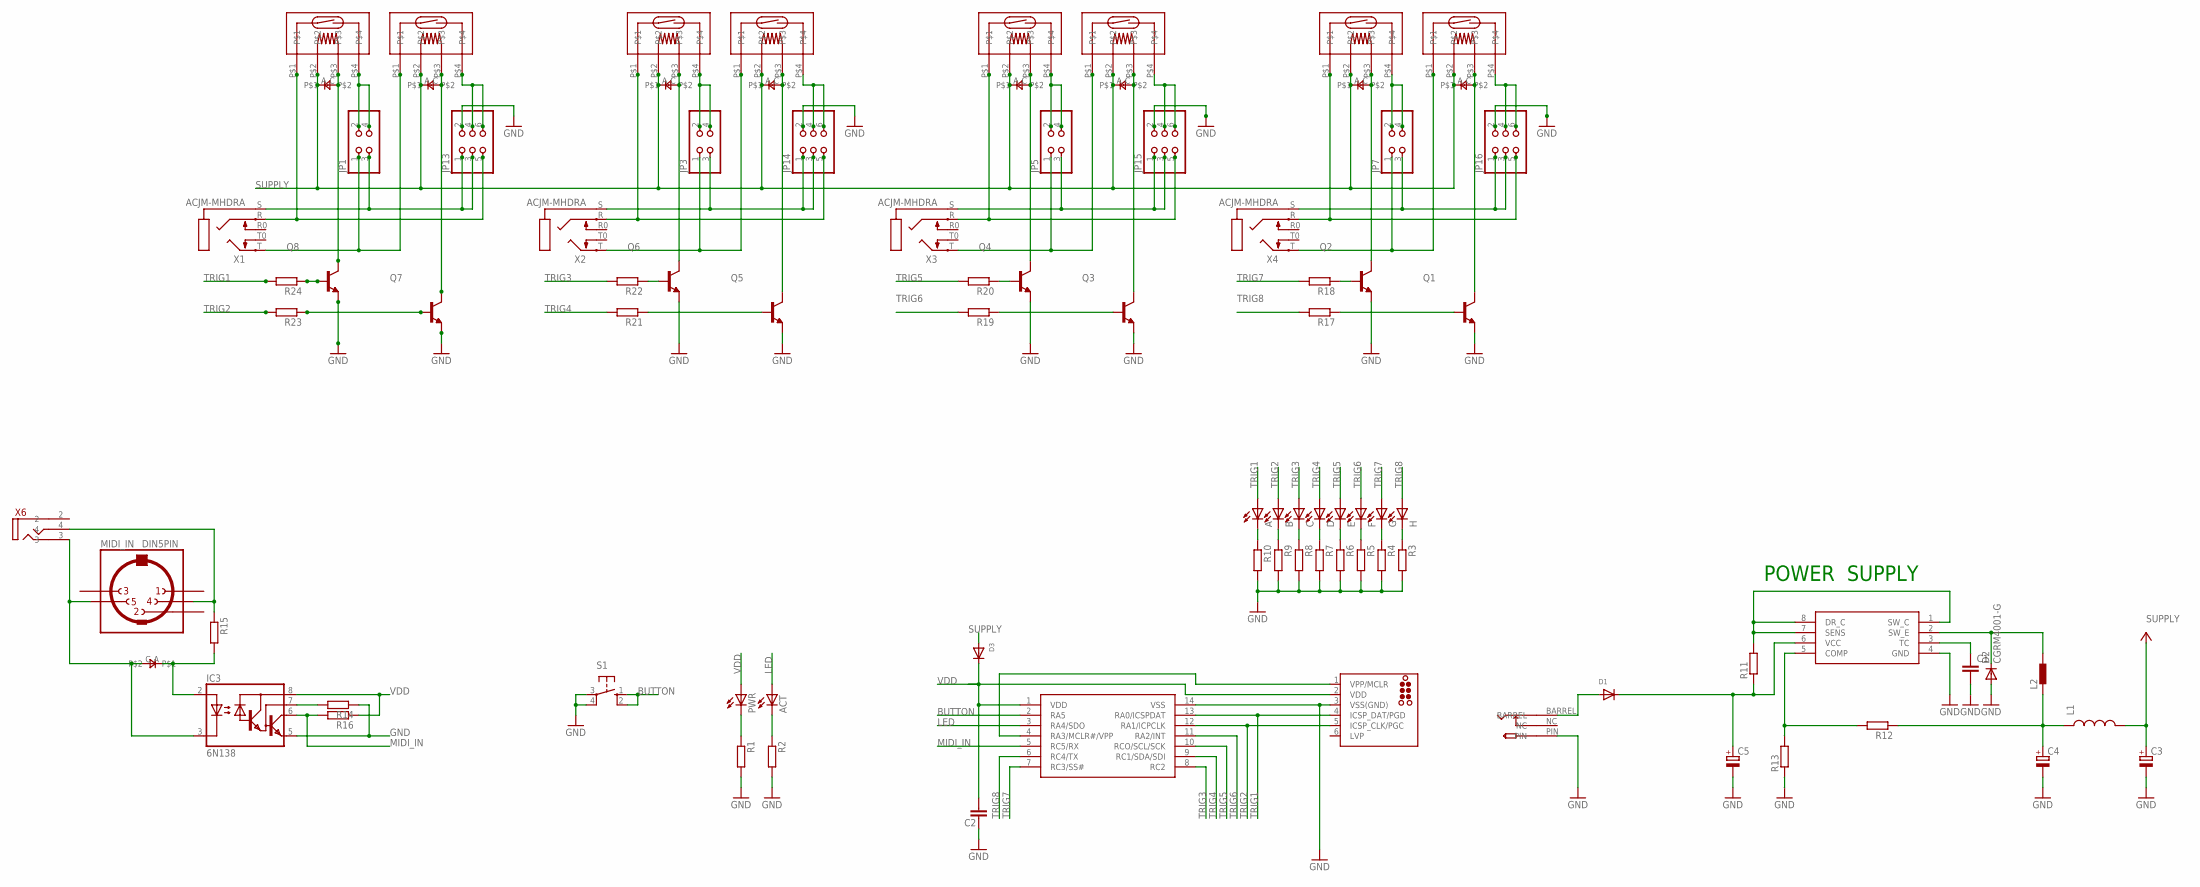
[picture p20: schematic midi_switcher_trs.sch]

Parts:
A: LED3MM
ACT: LED3MM
B: LED3MM
C: LED3MM
C1, C2: C-EUC0805; C0805
C3, C4, C5: CPOL-EUE2.5-7; E2,5-7
D: LED3MM
D1, D3: DIODESOD-123; SOD-123
D2: CGRM4001-G; SOD-123_MINI-SMA
D4, D5, D6, D7, D8, D9, D10, D11, D12: 0805DIODE
E: LED3MM
F: LED3MM
G: LED3MM
H: LED3MM
IC1: SP34063A_BOOST_REG; SOIC8
IC2: PIC16F1825SO14; SO14
IC3: 6N138; DIL08
ICSP: TC2030-MCP-NL
JP1, JP3, JP5, JP7: PINHD-2X2; 2X02
JP13, JP14, JP15, JP16: PINHD-2X3; 2X03
L1: INDUCTOR1210; 1210
L2: DR1030
MIDI_IN: DIN5PIN; EDGEDIN
PWR: LED3MM
Q1, Q2, Q3, Q4, Q5, Q6, Q7, Q8: MMBT3904LT1-NPN-SOT23-BEC; SOT23-BEC
R1, R2, R3, R4, R5, R6, R7, R8, R9, R10, R11, R12, R13, R14, R15, R16, R17, R18, R19, R20, R21, R22, R23, R24: R-EU_R0805; R0805
RLY1, RLY2, RLY3, RLY4, RLY5, RLY6, RLY7, RLY8: 9007-REED-RELAY
S1: 10-XX; B3F-10XX
U$9: PWR_SOCKET_2_1MM
X1, X2, X3, X4: ACJM-MHDRA; ACJM-MHDR
X6: VERTICAL_3_5MM_SOCKET

Connections:
+9V: C5.+, D1.C, IC1.6 (VCC), R11.1
BUTTON: IC2.2 (RA5), S1.1 (S), S1.2 (S1)
GND: C1.2, C2.2, C3.-, C4.-, C5.-, D2.A, IC1.4 (GND), IC2.14 (VSS), IC3.5 (GND), ICSP.3 (VSS(GND)), JP13.2, JP14.2, JP15.2, JP16.2, Q1.E, Q2.E, Q3.E, Q4.E, Q5.E, Q6.E, Q7.E, Q8.E, R1.2, R2.2, R3.2, R4.2, R5.2, R6.2, R7.2, R8.2, R9.2, R10.2, R13.1, R14.1, S1.3, S1.4 (P1), U$9.PIN
LED: ACT.A, IC2.3 (RA4/SDO)
MIDI_IN: IC2.5 (RC5/RX), IC3.6 (VO), R16.2
unnamed: JP1.2, JP1.4, RLY1.P$4
unnamed: JP13.4, JP13.6, RLY2.P$4
unnamed: JP13.5, RLY1.P$1, X1.R (2)
unnamed: JP1.1, RLY2.P$1, X1.T (5)
unnamed: JP1.3, JP13.1, JP13.3, X1.S (1)
unnamed: D11.C, Q7.C, RLY2.P$3
unnamed: Q8.B, R24.1
unnamed: Q7.B, R23.1
unnamed: JP3.2, JP3.4, RLY3.P$4
unnamed: D12.C, Q8.C, RLY1.P$3
unnamed: JP14.4, JP14.6, RLY4.P$4
unnamed: JP14.5, RLY3.P$1, X2.R (2)
unnamed: JP3.1, RLY4.P$1, X2.T (5)
unnamed: JP3.3, JP14.1, JP14.3, X2.S (1)
unnamed: D10.C, Q6.C, RLY3.P$3
unnamed: D9.C, Q5.C, RLY4.P$3
unnamed: Q6.B, R22.1
unnamed: Q5.B, R21.1
unnamed: JP5.2, JP5.4, RLY5.P$4
unnamed: JP15.4, JP15.6, RLY6.P$4
unnamed: JP15.5, RLY5.P$1, X3.R (2)
unnamed: JP5.1, RLY6.P$1, X3.T (5)
unnamed: JP5.3, JP15.1, JP15.3, X3.S (1)
unnamed: D8.C, Q4.C, RLY5.P$3
unnamed: D7.C, Q3.C, RLY6.P$3
unnamed: Q4.B, R20.1
unnamed: Q3.B, R19.1
unnamed: JP16.4, JP16.6, RLY8.P$4
unnamed: JP7.2, JP7.4, RLY7.P$4
unnamed: JP16.5, RLY7.P$1, X4.R (2)
unnamed: JP7.1, RLY8.P$1, X4.T (5)
unnamed: JP7.3, JP16.1, JP16.3, X4.S (1)
unnamed: D6.C, Q2.C, RLY7.P$3
unnamed: D5.C, Q1.C, RLY8.P$3
unnamed: Q2.B, R18.1
unnamed: Q1.B, R17.1
unnamed: D4.C, IC3.3 (C), MIDI_IN.5, X6.3
unnamed: MIDI_IN.4, R15.1, X6.4
unnamed: D4.A, IC3.2 (A), R15.2
unnamed: IC3.7 (VB), R14.2
unnamed: PWR.K (C), R1.1
unnamed: D1.A, U$9.BARREL
unnamed: IC1.1 (SW_C), IC1.7 (SENS), IC1.8 (DR_C), R11.2
unnamed: C1.1, IC1.3 (TC)
unnamed: D2.C, IC1.2 (SW_E), L2.2
unnamed: IC1.5 (COMP), R12.2, R13.2
unnamed: ACT.K (C), R2.1
unnamed: A.K (C), R10.1
unnamed: B.K (C), R9.1
unnamed: C.K (C), R8.1
unnamed: D.K (C), R7.1
unnamed: E.K (C), R6.1
unnamed: F.K (C), R5.1
unnamed: G.K (C), R4.1
unnamed: H.K (C), R3.1
unnamed: C4.+, L1.1, L2.1, R12.1
SUPPLY: C3.+, D3.A, D5.A, D6.A, D7.A, D8.A, D9.A, D10.A, D11.A, D12.A, L1.2, RLY1.P$2, RLY2.P$2, RLY3.P$2, RLY4.P$2, RLY5.P$2, RLY6.P$2, RLY7.P$2, RLY8.P$2
TRIG1: A.A, IC2.13 (RA0/ICSPDAT), ICSP.4 (ICSP_DAT/PGD), R24.2
TRIG2: B.A, IC2.12 (RA1/ICPCLK), ICSP.5 (ICSP_CLK/PGC), R23.2
TRIG3: C.A, IC2.8 (RC2), R22.2
TRIG4: D.A, IC2.9 (RC1/SDA/SDI), R21.2
TRIG5: E.A, IC2.10 (RCO/SCL/SCK), R20.2
TRIG6: F.A, IC2.11 (RA2/INT), R19.2
TRIG7: G.A, IC2.7 (RC3/SS#), R18.2
TRIG8: H.A, IC2.6 (RC4/TX), R17.2
VDD: C2.1, D3.C, IC2.1 (VDD), IC3.8 (VCC), ICSP.2 (VDD), PWR.A, R16.1
VPP: IC2.4 (RA3/MCLR#/VPP), ICSP.1 (VPP/MCLR)

Notes on the sheet:
POWER SUPPLY

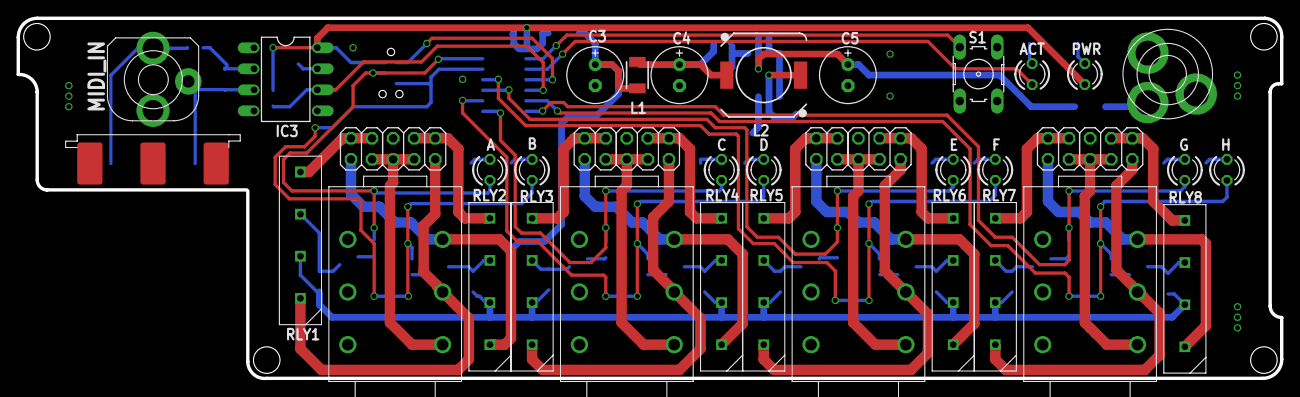
[picture p21: board midi_switcher_trs.brd from above]

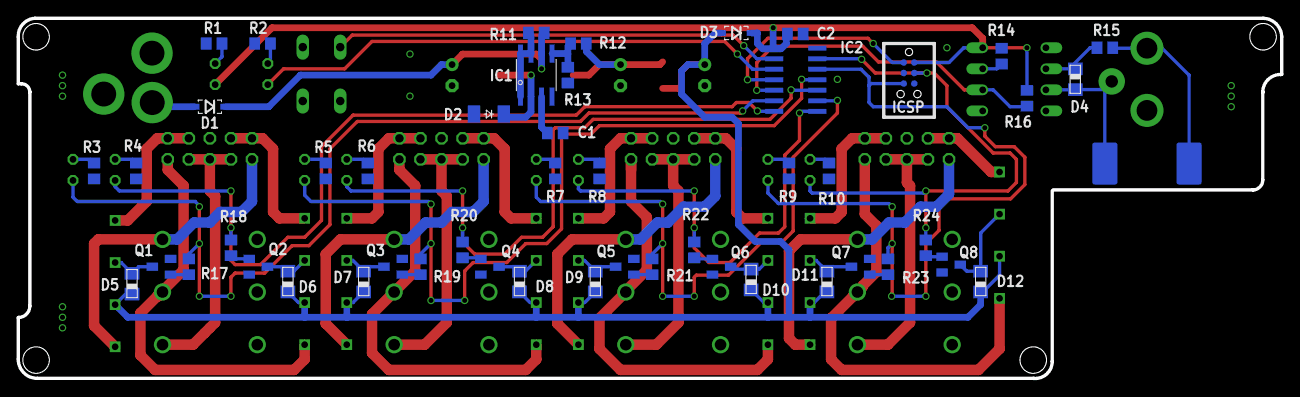
[picture p22: board midi_switcher_trs.brd from below]

Board: 2 copper layers, 152.4 x 43.4 mm, 89 parts (49 on the bottom side), 72 nets.
