hotchk155/MIDI-Switcher-2/panel/midi-switcher-panel5.brd

## EAGLE design panel/midi-switcher-panel5.brd (2020-09-29)

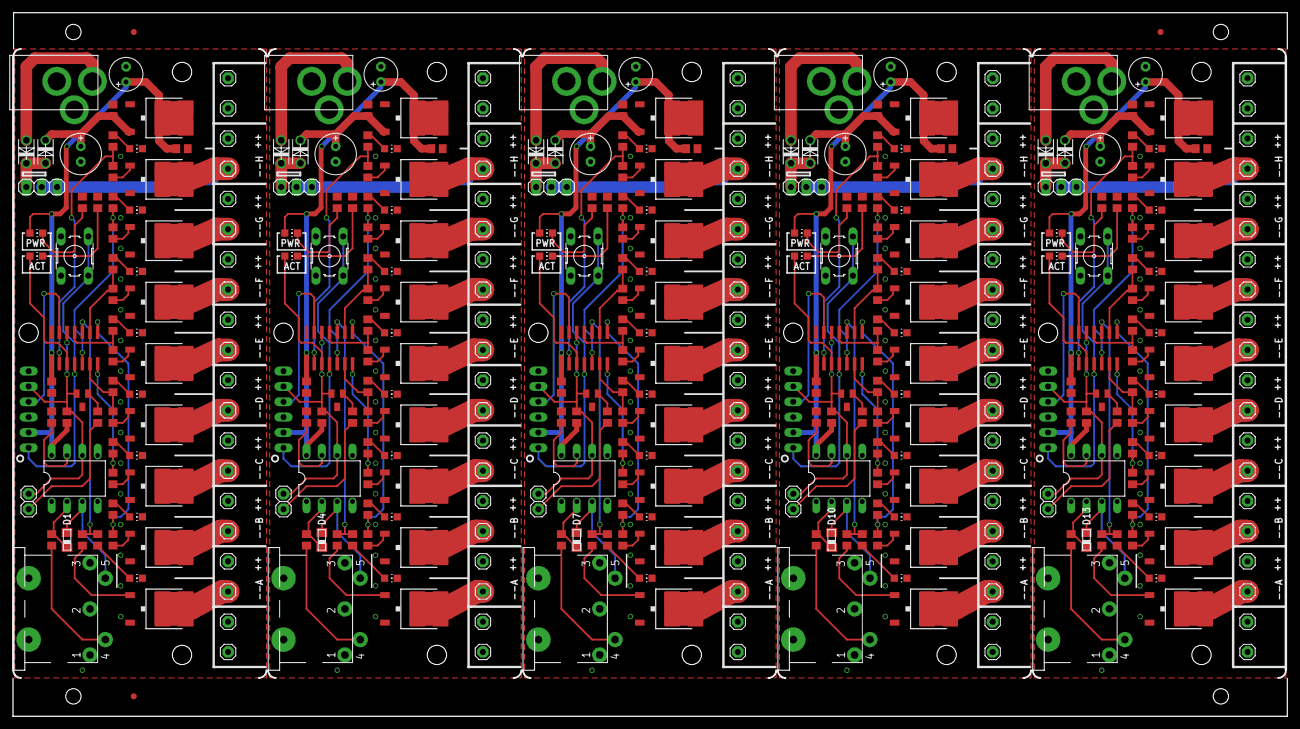
[picture p25: board midi-switcher-panel5.brd from above]

Board: 2 copper layers, 211.0 x 116.5 mm, 398 parts (0 on the bottom side), 250 nets.

Parts:
C1, C2, C3, C6, C7, C8, C11, C12, C13, C16, C17, C18, C21, C22, C23: C0805
C4, C10, C15, C20, C25: E2,5-7
C5, C9, C14, C19, C24: E2,5-6
CHAIN_NEXT, CHAIN_NEXT1, CHAIN_NEXT2, CHAIN_NEXT3, CHAIN_NEXT4: 1X01
CHAIN_PREV, CHAIN_PREV1, CHAIN_PREV2, CHAIN_PREV3, CHAIN_PREV4: 1X01
D1, D4, D7, D10, D13: 0805DIODE
D2, D3, D5, D6, D8, D9, D11, D12, D14, D15: 1N4004; DO-VERT
E$1, E$2, E$3: FIDUCIAL_1MM
IC1, IC5, IC8, IC11, IC14: 6N138; DIL08
IC2, IC4, IC7, IC10, IC13: PIC16F1825SO14; SO14
IC3, IC6, IC9, IC12, IC15: LD1086; DPACK
ICSP, ICSP1, ICSP2, ICSP3, ICSP4: 1X06_OVAL
JP1, JP2, JP3, JP4, JP5: 1X03
L1, L2, L3, L4, L5, L6, L7, L8, L9, L10, L11, L12, L13, L14, L15, L16, L17, L18, L19, L20, L21, L22, L23, L24, L25, L26, L27, L28, L29, L30, L31, L32, L33, L34, L35, L36, L37, L38, L39, L40, L41, L42, L43, L44, L45, L46, L47, L48, L49, L50: CHIP-LED0805
MIDI_IN, MIDI_IN1, MIDI_IN2, MIDI_IN3, MIDI_IN4: DIN5PIN"; TRUCONN90
MODE, MODE1, MODE2, MODE3, MODE4: B3F-10XX
OP1+, OP1+1, OP1+2, OP1+3, OP1+4, OP1-, OP1-1, OP1-2, OP1-3, OP1-4, OP2+, OP2+1, OP2+2, OP2+3, OP2+4, OP2-, OP2-1, OP2-2, OP2-3, OP2-4, OP3+, OP3+1, OP3+2, OP3+3, OP3+4, OP3-, OP3-1, OP3-2, OP3-3, OP3-4, OP4+, OP4+1, OP4+2, OP4+3, OP4+4, OP4-, OP4-1, OP4-2, OP4-3, OP4-4, OP5+, OP5+1, OP5+2, OP5+3, OP5+4, OP5-, OP5-1, OP5-2, OP5-3, OP5-4, OP6-, OP6-1, OP6-2, OP6-3, OP6-4, OP7+, OP7+1, OP7+2, OP7+3, OP7+4, OP7-, OP7-1, OP7-2, OP7-3, OP7-4, OP8+, OP8+1, OP8+2, OP8+3, OP8+4, OP8+5, OP8+6, OP8+7, OP8+8, OP8+9, OP8-, OP8-1, OP8-2, OP8-3, OP8-4: 1X01
POWER+1, POWER+2, POWER+3, POWER+4, POWER+5, POWER+6, POWER+7, POWER+8, POWER+9, POWER+10: 1X01
POWER-1, POWER-2, POWER-3, POWER-4, POWER-5, POWER-6, POWER-7, POWER-8, POWER-9, POWER-10: 1X01
Q1, Q2, Q3, Q4, Q5, Q6, Q7, Q8, Q10, Q11, Q12, Q13, Q14, Q15, Q16, Q17, Q19, Q20, Q21, Q22, Q23, Q24, Q25, Q26, Q28, Q29, Q30, Q31, Q32, Q33, Q34, Q35, Q37, Q38, Q39, Q40, Q41, Q42, Q43, Q44: MJD122GDPAK; DPACK
Q9, Q18, Q27, Q36, Q45: SOT23-BEC
R1, R2, R3, R4, R5, R6, R7, R8, R9, R10, R11, R12, R13, R14, R15, R16, R17, R18, R19, R20, R21, R22, R23, R24, R25, R26, R27, R28, R29, R30, R31, R32, R33, R34, R35, R36, R37, R38, R39, R40, R41, R42, R43, R44, R45, R46, R47, R48, R49, R50, R51, R52, R53, R54, R55, R56, R57, R58, R59, R60, R61, R62, R63, R64, R65, R66, R67, R68, R69, R70, R71, R72, R73, R74, R75, R76, R77, R78, R79, R80, R81, R82, R83, R84, R85, R86, R87, R88, R89, R90, R91, R92, R93, R94, R95, R96, R97, R98, R99, R100, R101, R102, R103, R104, R105, R106, R107, R108, R109, R110: R0805
U$1, U$2, U$3, U$4, U$5: 2.1MMJACKTHM; PJ-102A

Connections:
+5V: C1.2, C2.1, C5.+, IC1.8, IC2.1, IC3.2, ICSP.2, L2.A, R22.2
+5V1: C6.1, C7.2, C9.+, IC4.1, IC5.8, IC6.2, ICSP1.2, L19.A, R5.2
+5V2: C11.1, C12.2, C14.+, IC7.1, IC8.8, IC9.2, ICSP2.2, L29.A, R46.2
+5V3: C16.1, C17.2, C19.+, IC10.1, IC11.8, IC12.2, ICSP3.2, L39.A, R68.2
+5V4: C21.1, C22.2, C24.+, IC13.1, IC14.8, IC15.2, ICSP4.2, L49.A, R90.2
+12V: JP3.2, JP3.3, OP1+.1, OP2+.1, OP3+.1, OP4+.1, OP5+.1, OP7+.1, OP8+.1, OP8+1.1, POWER+1.1, POWER+2.1
+12V1: JP1.2, JP1.3, OP1+1.1, OP2+1.1, OP3+1.1, OP4+1.1, OP5+1.1, OP7+1.1, OP8+2.1, OP8+3.1, POWER+3.1, POWER+4.1
+12V2: JP2.2, JP2.3, OP1+2.1, OP2+2.1, OP3+2.1, OP4+2.1, OP5+2.1, OP7+2.1, OP8+4.1, OP8+5.1, POWER+5.1, POWER+6.1
+12V3: JP4.2, JP4.3, OP1+3.1, OP2+3.1, OP3+3.1, OP4+3.1, OP5+3.1, OP7+3.1, OP8+6.1, OP8+7.1, POWER+7.1, POWER+8.1
+12V4: JP5.2, JP5.3, OP1+4.1, OP2+4.1, OP3+4.1, OP4+4.1, OP5+4.1, OP7+4.1, OP8+8.1, OP8+9.1, POWER+9.1, POWER+10.1
ACT_LED: IC2.3, L1.A
ACT_LED1: IC4.3, L20.A
ACT_LED2: IC7.3, L30.A
ACT_LED3: IC10.3, L40.A
ACT_LED4: IC13.3, L50.A
GND: C1.1, C2.2, C3.1, C4.-, C5.-, IC1.5, IC2.14, IC3.1, ICSP.3, L3.C, L4.C, L5.C, L6.C, L7.C, L8.C, L9.C, L10.C, MODE.3, MODE.4, POWER-1.1, POWER-2.1, Q1.3, Q2.3, Q3.3, Q4.3, Q5.3, Q6.3, Q7.3, Q8.3, Q9.C, R21.1, R24.2, R25.2, U$1.RING
GND1: C6.2, C7.1, C8.1, C9.-, C10.-, IC4.14, IC5.5, IC6.1, ICSP1.3, L11.C, L12.C, L13.C, L14.C, L15.C, L16.C, L17.C, L18.C, MODE1.3, MODE1.4, POWER-3.1, POWER-4.1, Q10.3, Q11.3, Q12.3, Q13.3, Q14.3, Q15.3, Q16.3, Q17.3, Q18.C, R6.1, R42.2, R43.2, U$2.RING
GND2: C11.2, C12.1, C13.1, C14.-, C15.-, IC7.14, IC8.5, IC9.1, ICSP2.3, L21.C, L22.C, L23.C, L24.C, L25.C, L26.C, L27.C, L28.C, MODE2.3, MODE2.4, POWER-5.1, POWER-6.1, Q19.3, Q20.3, Q21.3, Q22.3, Q23.3, Q24.3, Q25.3, Q26.3, Q27.C, R47.1, R64.2, R65.2, U$3.RING
GND3: C16.2, C17.1, C18.1, C19.-, C20.-, IC10.14, IC11.5, IC12.1, ICSP3.3, L31.C, L32.C, L33.C, L34.C, L35.C, L36.C, L37.C, L38.C, MODE3.3, MODE3.4, POWER-7.1, POWER-8.1, Q28.3, Q29.3, Q30.3, Q31.3, Q32.3, Q33.3, Q34.3, Q35.3, Q36.C, R69.1, R86.2, R87.2, U$4.RING
GND4: C21.2, C22.1, C23.1, C24.-, C25.-, IC13.14, IC14.5, IC15.1, ICSP4.3, L41.C, L42.C, L43.C, L44.C, L45.C, L46.C, L47.C, L48.C, MODE4.3, MODE4.4, POWER-9.1, POWER-10.1, Q37.3, Q38.3, Q39.3, Q40.3, Q41.3, Q42.3, Q43.3, Q44.3, Q45.C, R91.1, R108.2, R109.2, U$5.RING
MIDI_IN: CHAIN_NEXT.1, IC1.6, IC2.12, ICSP.5, Q9.E, R22.1
MIDI_IN1: CHAIN_NEXT1.1, IC4.12, IC5.6, ICSP1.5, Q18.E, R5.1
MIDI_IN2: CHAIN_NEXT2.1, IC7.12, IC8.6, ICSP2.5, Q27.E, R46.1
MIDI_IN3: CHAIN_NEXT3.1, IC10.12, IC11.6, ICSP3.5, Q36.E, R68.1
MIDI_IN4: CHAIN_NEXT4.1, IC13.12, IC14.6, ICSP4.5, Q45.E, R90.1
unnamed: D1.C, IC1.3, MIDI_IN.5
unnamed: MIDI_IN.4, R1.2
unnamed: D1.A, IC1.2, R1.1
unnamed: IC1.7, R21.2
unnamed: L1.C, R25.1
unnamed: L10.A, R20.2
unnamed: L9.A, R18.2
unnamed: Q8.1, R19.1
unnamed: Q7.1, R17.1
unnamed: Q6.1, R15.1
unnamed: Q5.1, R13.1
unnamed: Q4.1, R11.1
unnamed: Q3.1, R9.1
unnamed: Q2.1, R7.1
unnamed: Q1.1, R2.1
unnamed: Q9.B, R23.2
unnamed: Q11.1, R27.1
unnamed: CHAIN_PREV.1, R23.1
unnamed: Q12.1, R28.1
unnamed: Q13.1, R29.1
unnamed: Q14.1, R30.1
unnamed: Q15.1, R31.1
unnamed: Q16.1, R32.1
unnamed: L8.A, R16.2
unnamed: OP1-.1, Q8.2
unnamed: OP2-.1, Q7.2
unnamed: OP3-.1, Q6.2
unnamed: L2.C, R24.1
unnamed: OP5-.1, Q4.2
unnamed: OP6-.1, Q3.2
unnamed: OP4-.1, Q5.2
unnamed: Q17.1, R33.1
unnamed: L7.A, R14.2
unnamed: L11.A, R34.2
unnamed: L6.A, R12.2
unnamed: L5.A, R10.2
unnamed: L4.A, R8.2
unnamed: L3.A, R3.2
unnamed: C3.2, C4.+, D3.C, IC3.3
unnamed: L12.A, R35.2
unnamed: L13.A, R36.2
unnamed: OP7-.1, Q2.2
unnamed: D2.A, U$1.TIP
unnamed: L14.A, R37.2
unnamed: L15.A, R38.2
unnamed: L16.A, R39.2
unnamed: OP8-.1, Q1.2
unnamed: L17.A, R40.2
unnamed: L18.A, R41.2
unnamed: C8.2, C10.+, D5.C, IC6.3
unnamed: IC2.13, ICSP.4
unnamed: OP1-1.1, Q10.2
unnamed: OP2-1.1, Q11.2
unnamed: D2.C, D3.A, JP3.1
unnamed: OP3-1.1, Q12.2
unnamed: OP5-1.1, Q14.2
unnamed: OP6-1.1, Q15.2
unnamed: OP4-1.1, Q13.2
unnamed: OP7-1.1, Q16.2
unnamed: OP8-1.1, Q17.2
unnamed: IC4.13, ICSP1.4
unnamed: D6.A, U$2.TIP
unnamed: D5.A, D6.C, JP1.1
unnamed: L19.C, R42.1
unnamed: L20.C, R43.1
unnamed: D4.C, IC5.3, MIDI_IN1.5
unnamed: MIDI_IN1.4, R4.2
unnamed: D4.A, IC5.2, R4.1
unnamed: IC5.7, R6.2
unnamed: Q18.B, R44.2
unnamed: CHAIN_PREV1.1, R44.1
unnamed: Q10.1, R26.1
unnamed: Q20.1, R49.1
unnamed: Q21.1, R50.1
unnamed: Q22.1, R51.1
unnamed: Q23.1, R52.1
unnamed: Q24.1, R53.1
unnamed: Q25.1, R54.1
unnamed: Q26.1, R55.1
unnamed: L21.A, R56.2
unnamed: L22.A, R57.2
unnamed: L23.A, R58.2
unnamed: L24.A, R59.2
unnamed: L25.A, R60.2
unnamed: L26.A, R61.2
unnamed: L27.A, R62.2
unnamed: L28.A, R63.2
unnamed: C13.2, C15.+, D8.C, IC9.3
unnamed: OP1-2.1, Q19.2
unnamed: OP2-2.1, Q20.2
unnamed: OP3-2.1, Q21.2
unnamed: OP5-2.1, Q23.2
unnamed: OP6-2.1, Q24.2
unnamed: OP4-2.1, Q22.2
unnamed: OP7-2.1, Q25.2
unnamed: OP8-2.1, Q26.2
unnamed: IC7.13, ICSP2.4
unnamed: D9.A, U$3.TIP
unnamed: D8.A, D9.C, JP2.1
unnamed: L29.C, R64.1
unnamed: L30.C, R65.1
unnamed: D7.C, IC8.3, MIDI_IN2.5
unnamed: MIDI_IN2.4, R45.2
unnamed: D7.A, IC8.2, R45.1
unnamed: IC8.7, R47.2
unnamed: Q27.B, R66.2
unnamed: CHAIN_PREV2.1, R66.1
unnamed: Q19.1, R48.1
unnamed: Q29.1, R71.1
unnamed: Q30.1, R72.1
unnamed: Q31.1, R73.1
unnamed: Q32.1, R74.1
unnamed: Q33.1, R75.1
unnamed: Q34.1, R76.1
unnamed: Q35.1, R77.1
unnamed: L31.A, R78.2
unnamed: L32.A, R79.2
unnamed: L33.A, R80.2
unnamed: L34.A, R81.2
unnamed: L35.A, R82.2
unnamed: L36.A, R83.2
unnamed: L37.A, R84.2
unnamed: L38.A, R85.2
unnamed: C18.2, C20.+, D11.C, IC12.3
unnamed: OP1-3.1, Q28.2
unnamed: OP2-3.1, Q29.2
unnamed: OP3-3.1, Q30.2
unnamed: OP5-3.1, Q32.2
unnamed: OP6-3.1, Q33.2
unnamed: OP4-3.1, Q31.2
unnamed: OP7-3.1, Q34.2
unnamed: OP8-3.1, Q35.2
unnamed: IC10.13, ICSP3.4
unnamed: D12.A, U$4.TIP
unnamed: D11.A, D12.C, JP4.1
unnamed: L39.C, R86.1
unnamed: L40.C, R87.1
unnamed: D10.C, IC11.3, MIDI_IN3.5
unnamed: MIDI_IN3.4, R67.2
unnamed: D10.A, IC11.2, R67.1
unnamed: IC11.7, R69.2
unnamed: Q36.B, R88.2
unnamed: CHAIN_PREV3.1, R88.1
unnamed: Q28.1, R70.1
unnamed: Q38.1, R93.1
unnamed: Q39.1, R94.1
unnamed: Q40.1, R95.1
unnamed: Q41.1, R96.1
unnamed: Q42.1, R97.1
unnamed: Q43.1, R98.1
unnamed: Q44.1, R99.1
unnamed: L41.A, R100.2
unnamed: L42.A, R101.2
unnamed: L43.A, R102.2
unnamed: L44.A, R103.2
unnamed: L45.A, R104.2
unnamed: L46.A, R105.2
unnamed: L47.A, R106.2
unnamed: L48.A, R107.2
unnamed: C23.2, C25.+, D14.C, IC15.3
unnamed: OP1-4.1, Q37.2
unnamed: OP2-4.1, Q38.2
unnamed: OP3-4.1, Q39.2
unnamed: OP5-4.1, Q41.2
unnamed: OP6-4.1, Q42.2
unnamed: OP4-4.1, Q40.2
unnamed: OP7-4.1, Q43.2
unnamed: OP8-4.1, Q44.2
unnamed: IC13.13, ICSP4.4
unnamed: D15.A, U$5.TIP
unnamed: D14.A, D15.C, JP5.1
unnamed: L49.C, R108.1
unnamed: L50.C, R109.1
unnamed: D13.C, IC14.3, MIDI_IN4.5
unnamed: MIDI_IN4.4, R89.2
unnamed: D13.A, IC14.2, R89.1
unnamed: IC14.7, R91.2
unnamed: Q45.B, R110.2
unnamed: CHAIN_PREV4.1, R110.1
unnamed: Q37.1, R92.1
OUT1: IC2.2, R19.2, R20.1
OUT2: IC2.5, R17.2, R18.1
OUT3: IC2.9, R15.2, R16.1
OUT4: IC2.11, R13.2, R14.1
OUT5: IC2.6, R11.2, R12.1
OUT6: IC2.7, R9.2, R10.1
OUT7: IC2.8, R7.2, R8.1
OUT8: IC2.10, R2.2, R3.1
OUT9: IC4.9, R28.2, R36.1
OUT10: IC4.11, R29.2, R37.1
OUT11: IC4.6, R30.2, R38.1
OUT12: IC4.7, R31.2, R39.1
OUT13: IC4.5, R27.2, R35.1
OUT14: IC4.2, R26.2, R34.1
OUT15: IC4.10, R33.2, R41.1
OUT16: IC4.8, R32.2, R40.1
OUT17: IC7.9, R50.2, R58.1
OUT18: IC7.11, R51.2, R59.1
OUT19: IC7.6, R52.2, R60.1
OUT20: IC7.7, R53.2, R61.1
OUT21: IC7.5, R49.2, R57.1
OUT22: IC7.2, R48.2, R56.1
OUT23: IC7.10, R55.2, R63.1
OUT24: IC7.8, R54.2, R62.1
OUT25: IC10.9, R72.2, R80.1
OUT26: IC10.11, R73.2, R81.1
OUT27: IC10.6, R74.2, R82.1
OUT28: IC10.7, R75.2, R83.1
OUT29: IC10.5, R71.2, R79.1
OUT30: IC10.2, R70.2, R78.1
OUT31: IC10.10, R77.2, R85.1
OUT32: IC10.8, R76.2, R84.1
OUT33: IC13.9, R94.2, R102.1
OUT34: IC13.11, R95.2, R103.1
OUT35: IC13.6, R96.2, R104.1
OUT36: IC13.7, R97.2, R105.1
OUT37: IC13.5, R93.2, R101.1
OUT38: IC13.2, R92.2, R100.1
OUT39: IC13.10, R99.2, R107.1
OUT40: IC13.8, R98.2, R106.1
SWITCH: IC2.4, ICSP.1, MODE.1, MODE.2
SWITCH1: IC4.4, ICSP1.1, MODE1.1, MODE1.2
SWITCH2: IC7.4, ICSP2.1, MODE2.1, MODE2.2
SWITCH3: IC10.4, ICSP3.1, MODE3.1, MODE3.2
SWITCH4: IC13.4, ICSP4.1, MODE4.1, MODE4.2
