hotchk155/MIDI-Switcher-2/(commit log)

2018-07-10 moved board to new project
    [midi-switcher-smt.brd, midi-switcher-smt.sch]
2018-08-23 pcb updates rev2
    [midi-switcher-smt.brd, midi-switcher-smt.sch]
2018-08-23 tidy up
    [midi-switcher-smt.brd]
2018-08-28 segment large pads/tidy up
    [midi-switcher-smt.brd, midi-switcher-smt.sch]
2018-12-02 v1.1 - allow latching mode and special reset states
    [msw.c, msw.h, switch.c]
2019-02-25 REV3 board - increase ground plane isolation on bottom
    [midi-switcher-smt.brd]
2019-02-25 Revert "REV3 board - increase ground plane isolation on bottom"
    This reverts commit 9a92895ae1f12a77b62d7c6f56f5905224b33e44.
    [midi-switcher-smt.brd]
2019-02-25 REV3 - increase bottom copper pour clearance. Silk changes
    [midi-switcher-smt.brd]
2019-03-11 change pin hole size
    [midi-switcher-panel5.brd]
2019-05-01 Support inverted output mode
    [msw.h, storage.c, switch.c]
2019-05-01 Invert option configured as flags byte
    [msw.h, switch.c]
2020-04-28 1.2 24apr20 support relay switcher
    [midi-switcher-stencil.brd]
2020-05-01 bring in new relay switcher stuff
    [bom.xlsx]
2020-05-01 relay stuff
    [relay_board.brd, relay_board.sch]
2020-09-29 Update midi-switcher-panel5.brd
    fix silk screen issues with panel
    [midi-switcher-panel5.brd]
2021-07-27 TRS switcher added
    [midi_switcher_trs.brd, midi_switcher_trs.sch]
2021-07-27 dpdt added
    [midi-switcher-dpdt.brd, midi-switcher-dpdt.sch]
2021-07-27 first layout dpdt
    [midi-switcher-dpdt.brd, midi-switcher-dpdt.sch]
2021-12-11 ssr switcher v1
    [ssr_board.brd, ssr_board.sch]
2024-10-24 Update Relay Switcher - User Guide.docx
2024-10-24 Update MIDI Switcher - Sysex Spec.docx
2025-04-29 rename midi switcher to midi switcher smt
    [midi-switcher-smt.brd, midi-switcher-smt.sch]
2026-02-06 Rev 3B board (single) enlarge terminal pin holes
    [midi-switcher-bom.xlsx, midi-switcher-smt.brd, midi-switcher-smt.sch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]
2026-02-26 first cut xc8 vscode
