hotchk155/MIDI-Switcher-2/(notices)

Notices in the files:
panel/midi-switcher-panel5.brd:
creativecommons.org/licenses
parts and their libraries:
tag-connect: ©2009 ROFA.cz - modified and updated by Robert Darlington ‹rdarlington@gmail.com›
